denniscmcom/EVB-A32S1-M/README.md

# EVB-A32S1-M

A electronic speed controller based on a STM32 MCU. In the `Export` folder you can find an overview of the schematic, PCB and bill of materials.

## Schematic 

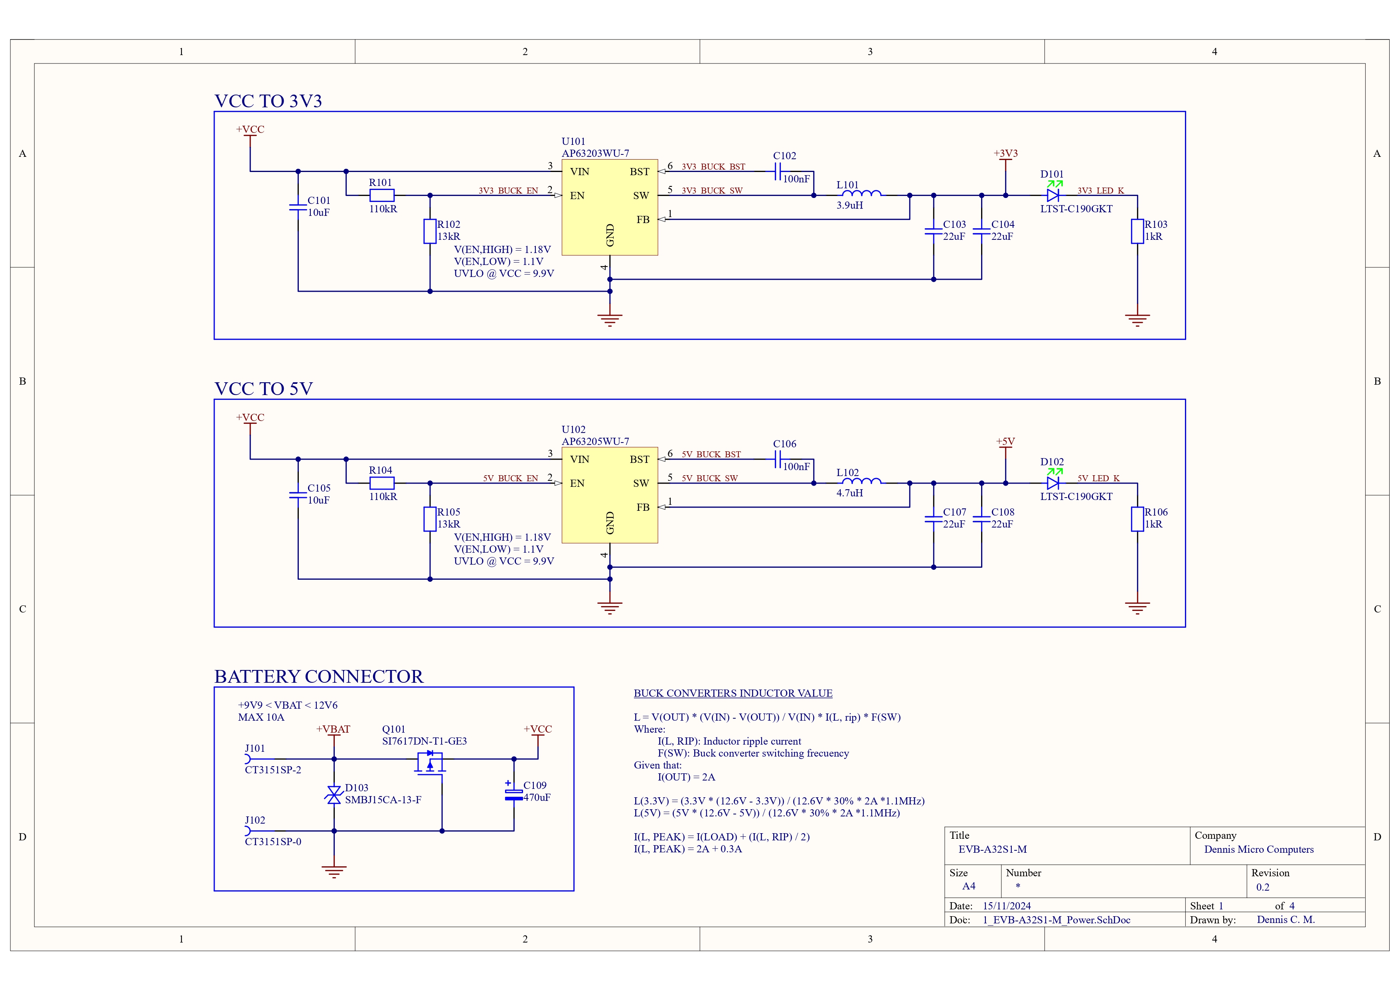
[picture p1: .github/SCH/SCH_page-0001.jpg]

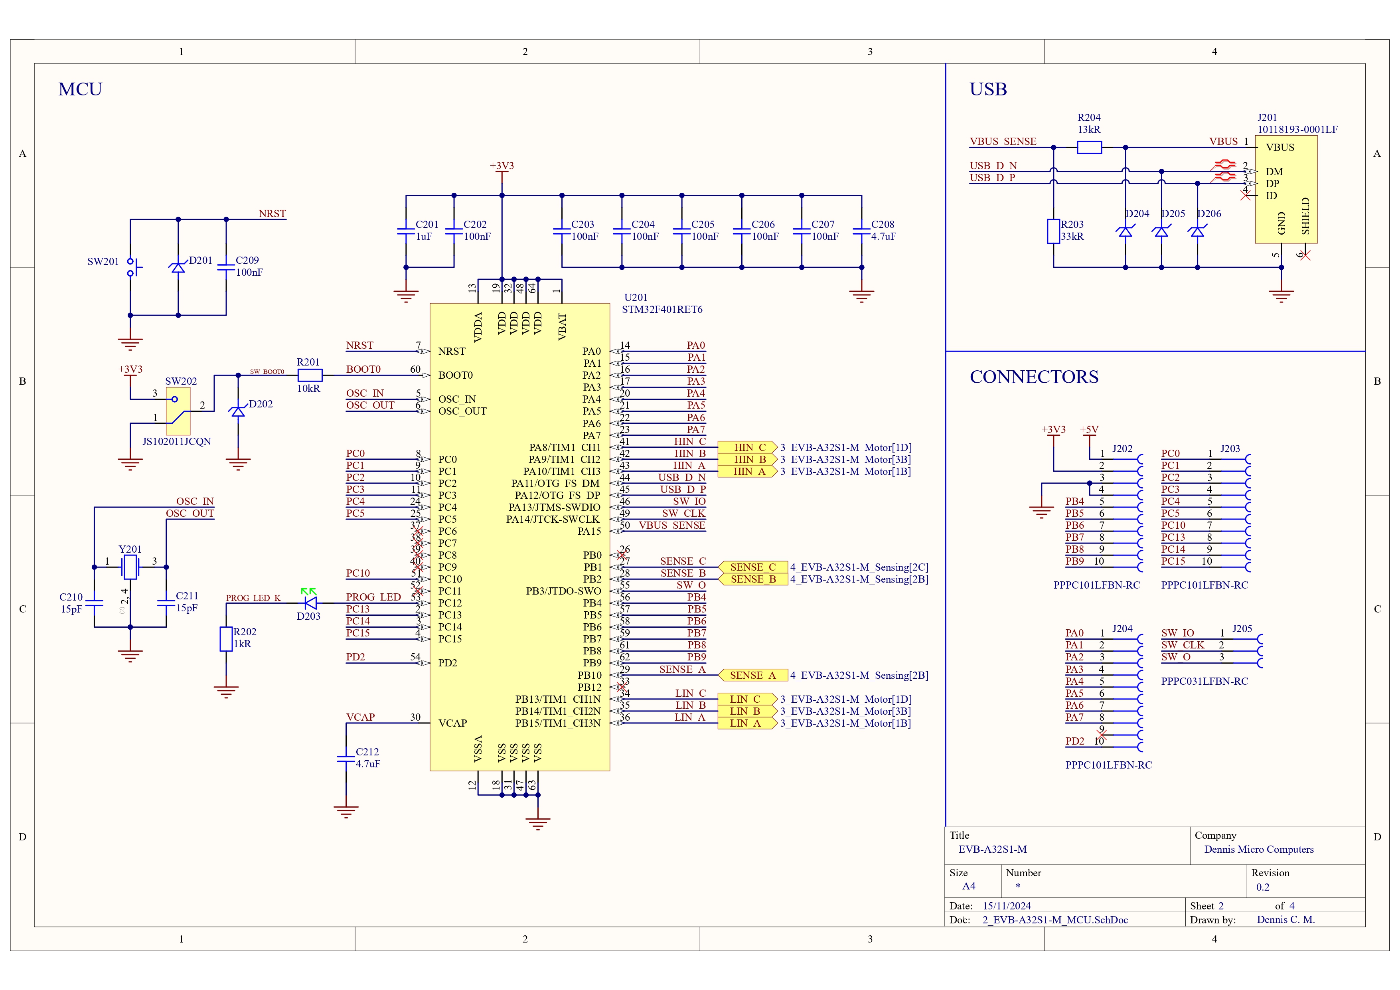
[picture p2: .github/SCH/SCH_page-0002.jpg]

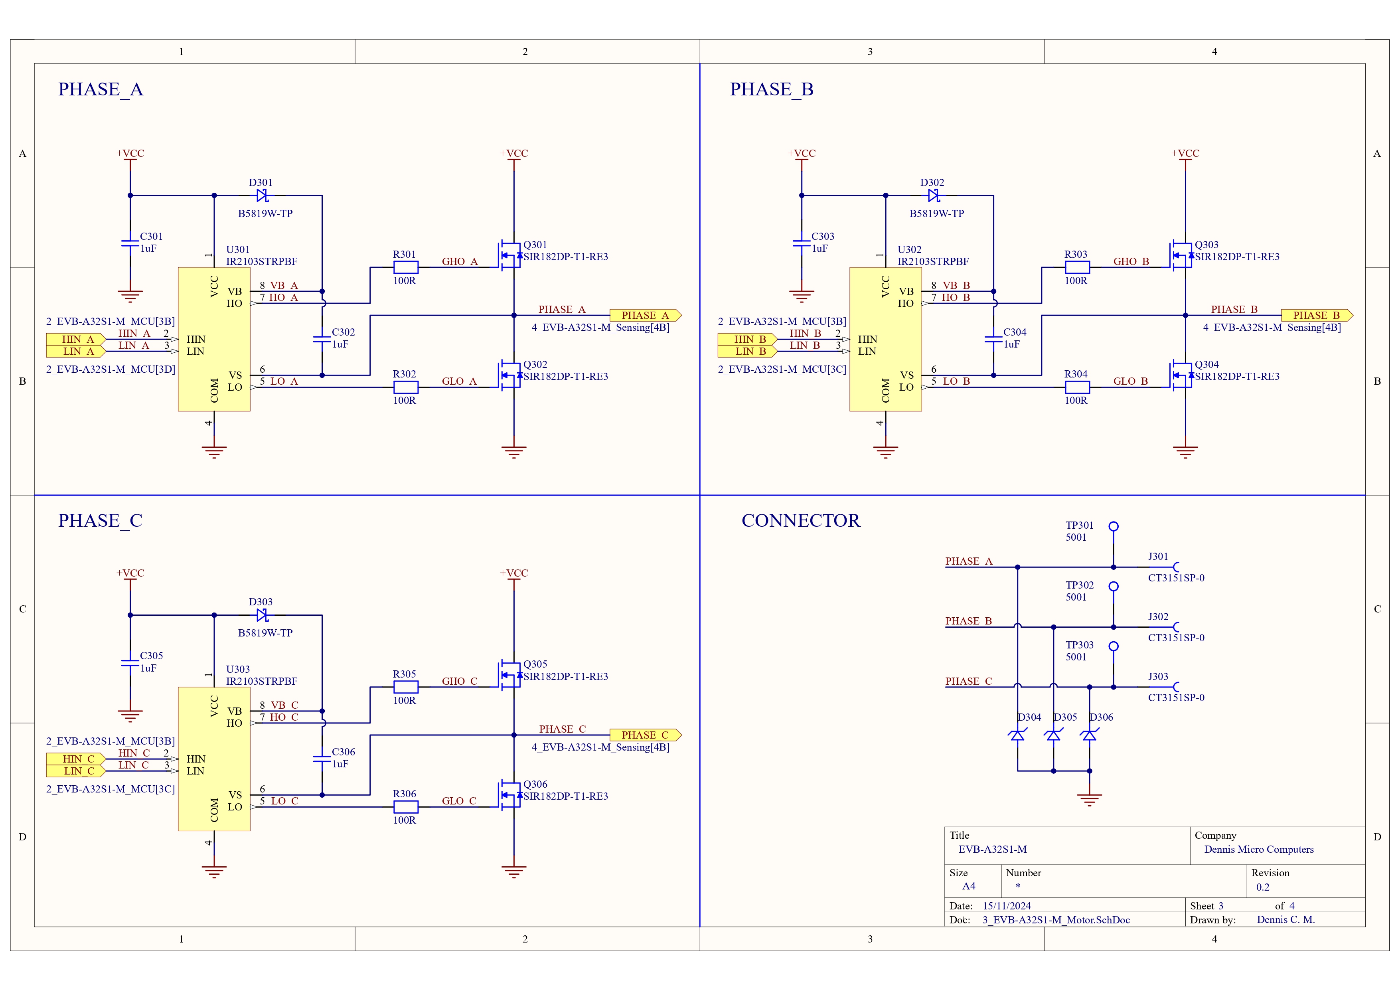
[picture p3: .github/SCH/SCH_page-0003.jpg]

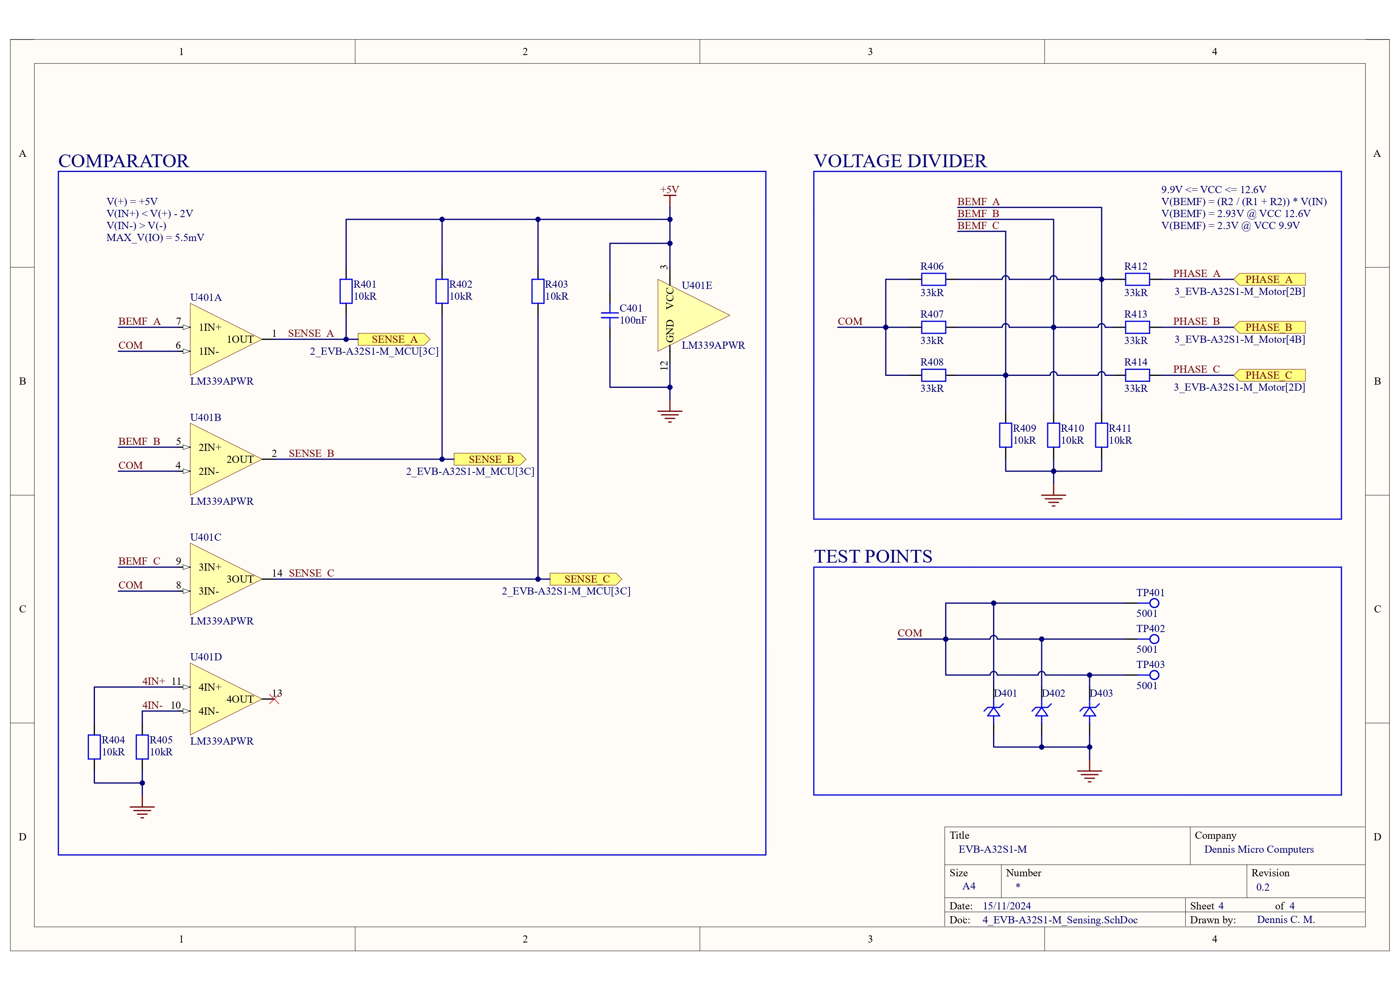
[picture p4: .github/SCH/SCH_page-0004.jpg]


## PCB

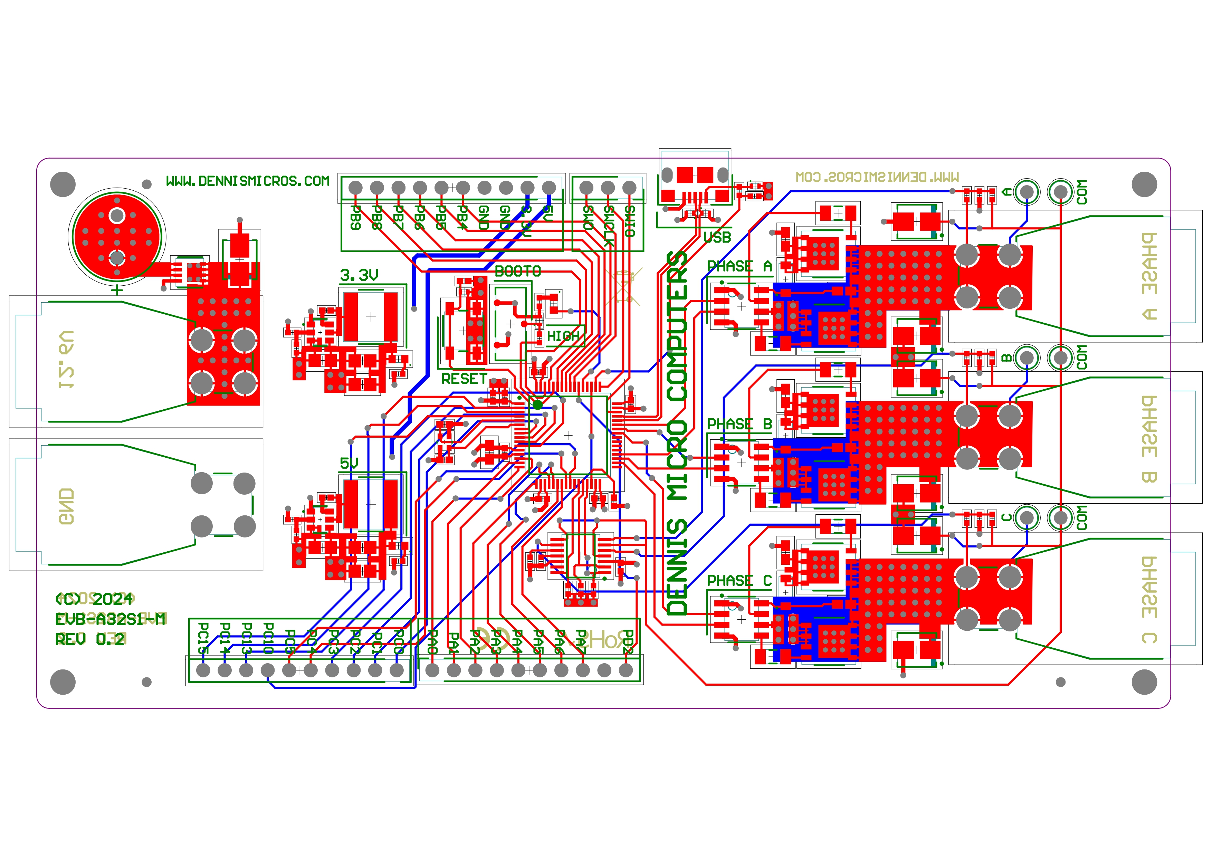
[picture p5: .github/PCB/PCB_page-0001.jpg]


## BOM

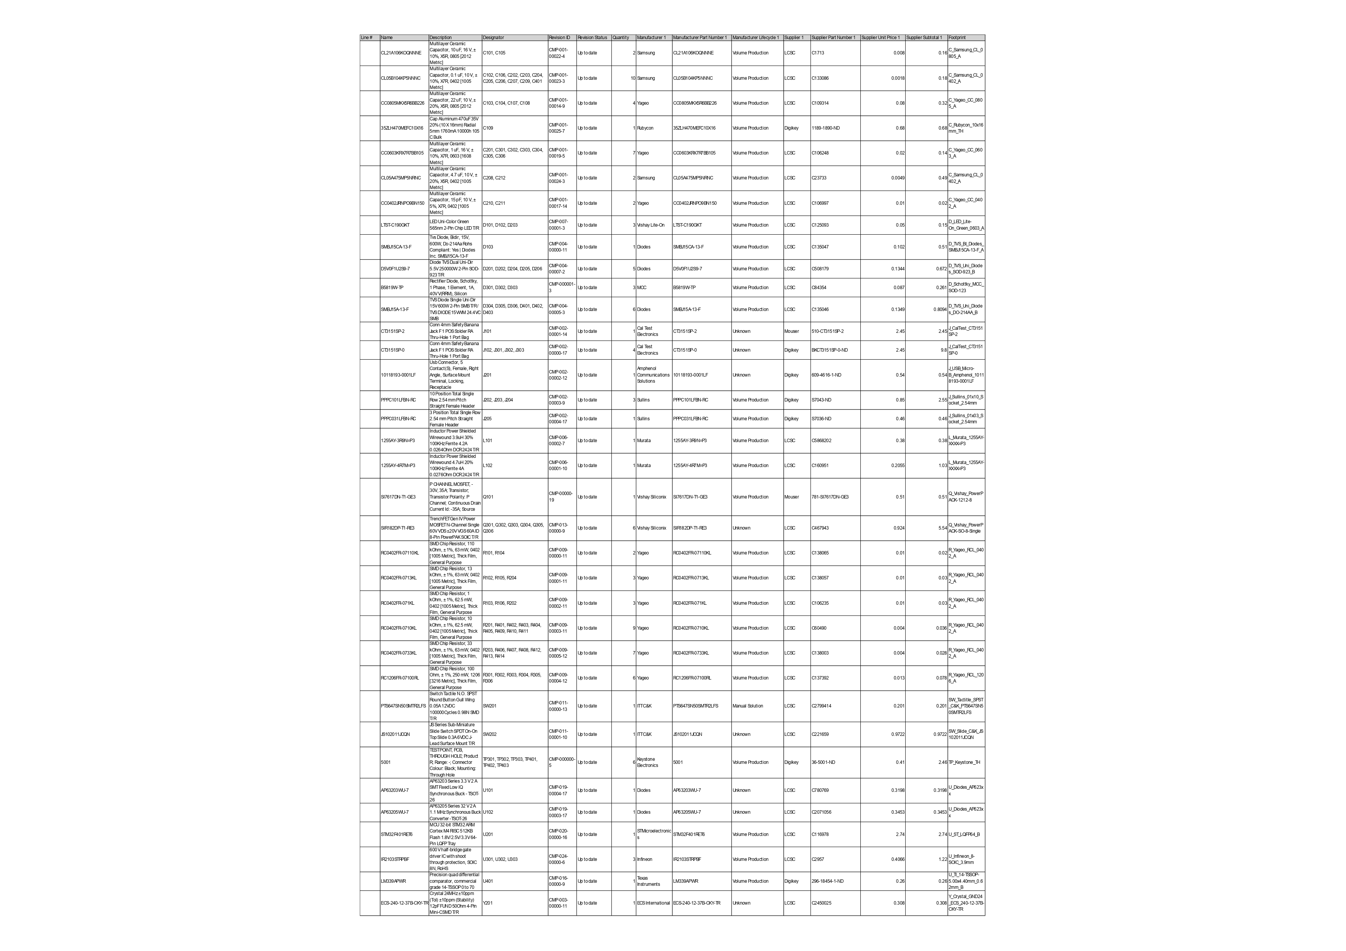
[picture p6: .github/BOM/BOM_page-0001.jpg]
