denniscmcom/EVB-A32S1-M/Export/BOM.pdf

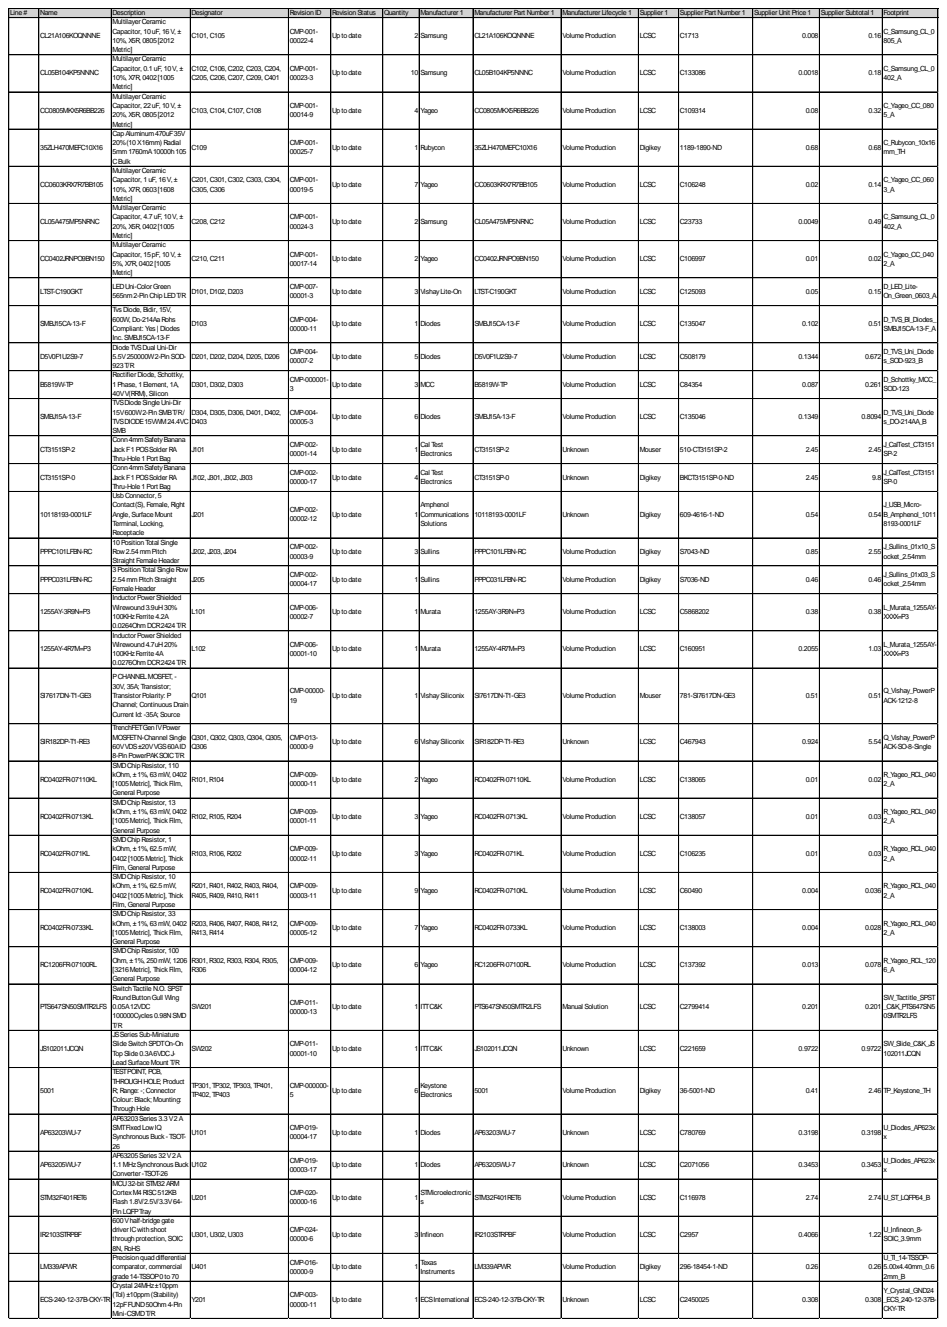
[picture p7: page 1]

Line# | Name | Description | Designator | RevisionID | RevisionStatus | Quantity | Manufacturer 1 | Manufacturer Part Number 1 | Manufacturer Lifecycle 1 | Supplier 1 | Supplier Part Number 1 | Supplier Unit Price1 | Supplier Subtotal 1 | Footprint

CL21A106KOQNNNE | Multilayer Ceramic Capacitor, 10uF, 16V, ± 10%, X5R, 0805[2012 Metric] | C101, C105 | CMP-001-00022-4 | Uptodate | 2 | Samsung | CL21A106KOQNNNE | VolumeProduction | LCSC | C1713 | 0.008 | 0.16 | C_Samsung_CL_0 805_A

CL05B104KP5NNNC | Multilayer Ceramic Capacitor, 0.1 uF, 10V, ± 10%, X7R, 0402[1005 Metric] | C102, C106, C202, C203, C204, C205, C206, C207, C209, C401 | CMP-001-00023-3 | Uptodate | 10 | Samsung | CL05B104KP5NNNC | VolumeProduction | LCSC | C133086 | 0.0018 | 0.18 | C_Samsung_CL_0 402_A

CC0805MKX5R6BB226 | Multilayer Ceramic Capacitor, 22uF, 10V, ± 20%, X5R, 0805[2012 Metric] | C103, C104, C107, C108 | CMP-001-00014-9 | Uptodate | 4 | Yageo | CC0805MKX5R6BB226 | VolumeProduction | LCSC | C109314 | 0.08 | 0.32 | C_Yageo_CC_080 5_A

35ZLH470MEFC10X16 | CapAluminum470uF35V 20%(10X16mm) Radial 5mm1760mA10000h105 CBulk | C109 | CMP-001-00025-7 | Uptodate | 1 | Rubycon | 35ZLH470MEFC10X16 | VolumeProduction | Digikey | 1189-1890-ND | 0.68 | 0.68 | C_Rubycon_10x16 mm_TH

CC0603KRX7R7BB105 | Multilayer Ceramic Capacitor, 1uF, 16V, ± 10%, X7R, 0603[1608 Metric] | C201, C301, C302, C303, C304, C305, C306 | CMP-001-00019-5 | Uptodate | 7 | Yageo | CC0603KRX7R7BB105 | VolumeProduction | LCSC | C106248 | 0.02 | 0.14 | C_Yageo_CC_060 3_A

CL05A475MP5NRNC | Multilayer Ceramic Capacitor, 4.7 uF, 10V, ± 20%, X5R, 0402[1005 Metric] | C208, C212 | CMP-001-00024-3 | Uptodate | 2 | Samsung | CL05A475MP5NRNC | VolumeProduction | LCSC | C23733 | 0.0049 | 0.49 | C_Samsung_CL_0 402_A

CC0402JRNPO9BN150 | Multilayer Ceramic Capacitor, 15pF, 10V, ± 5%, X7R, 0402[1005 Metric] | C210, C211 | CMP-001-00017-14 | Uptodate | 2 | Yageo | CC0402JRNPO9BN150 | VolumeProduction | LCSC | C106997 | 0.01 | 0.02 | C_Yageo_CC_040 2_A

LTST-C190GKT | LEDUni-Color Green 565nm2-Pin Chip LEDT/R | D101, D102, D203 | CMP-007-00001-3 | Uptodate | 3 | VishayLite-On | LTST-C190GKT | VolumeProduction | LCSC | C125093 | 0.05 | 0.15 | D_LED_Lite-On_Green_0603_A

SMBJ15CA-13-F | Tvs Diode, Bidir, 15V, 600W, Do-214AaRohs Compliant: Yes | Diodes Inc. SMBJ15CA-13-F | D103 | CMP-004-00000-11 | Uptodate | 1 | Diodes | SMBJ15CA-13-F | VolumeProduction | LCSC | C135047 | 0.102 | 0.51 | D_TVS_BI_Diodes_ SMBJ15CA-13-F_A

D5V0F1U2S9-7 | DiodeTVSDual Uni-Dir 5.5V250000W2-Pin SOD-923T/R | D201, D202, D204, D205, D206 | CMP-004-00007-2 | Uptodate | 5 | Diodes | D5V0F1U2S9-7 | VolumeProduction | LCSC | C508179 | 0.1344 | 0.672 | D_TVS_Uni_Diode s_SOD-923_B

B5819W-TP | Rectifier Diode, Schottky, 1Phase, 1Element, 1A, 40VV(RRM), Silicon | D301, D302, D303 | CMP-000001-3 | Uptodate | 3 | MCC | B5819W-TP | VolumeProduction | LCSC | C84354 | 0.087 | 0.261 | D_Schottky_MCC_ SOD-123

SMBJ15A-13-F | TVSDiodeSingle Uni-Dir 15V600W2-Pin SMBT/R/ TVSDIODE15VWM24.4VC SMB | D304, D305, D306, D401, D402, D403 | CMP-004-00005-3 | Uptodate | 6 | Diodes | SMBJ15A-13-F | VolumeProduction | LCSC | C135046 | 0.1349 | 0.8094 | D_TVS_Uni_Diode s_DO-214AA_B

CT3151SP-2 | Conn4mmSafetyBanana Jack F1POSSolder RA Thru-Hole 1Port Bag | J101 | CMP-002-00001-14 | Uptodate | 1 | Cal Test Electronics | CT3151SP-2 | Unknown | Mouser | 510-CT3151SP-2 | 2.45 | 2.45 | J_CalTest_CT3151 SP-2

CT3151SP-0 | Conn4mmSafetyBanana Jack F1POSSolder RA Thru-Hole 1Port Bag | J102, J301, J302, J303 | CMP-002-00000-17 | Uptodate | 4 | Cal Test Electronics | CT3151SP-0 | Unknown | Digikey | BKCT3151SP-0-ND | 2.45 | 9.8 | J_CalTest_CT3151 SP-0

10118193-0001LF | UsbConnector, 5 Contact(S), Female, Right Angle, SurfaceMount Terminal, Locking, Receptacle | J201 | CMP-002-00002-12 | Uptodate | 1 | Amphenol Communications Solutions | 10118193-0001LF | Unknown | Digikey | 609-4616-1-ND | 0.54 | 0.54 | J_USB_Micro-B_Amphenol_1011 8193-0001LF

PPPC101LFBN-RC | 10PositionTotal Single Row2.54mmPitch Straight Female Header | J202, J203, J204 | CMP-002-00003-9 | Uptodate | 3 | Sullins | PPPC101LFBN-RC | VolumeProduction | Digikey | S7043-ND | 0.85 | 2.55 | J_Sullins_01x10_S ocket_2.54mm

PPPC031LFBN-RC | 3PositionTotal Single Row 2.54mmPitchStraight Female Header | J205 | CMP-002-00004-17 | Uptodate | 1 | Sullins | PPPC031LFBN-RC | VolumeProduction | Digikey | S7036-ND | 0.46 | 0.46 | J_Sullins_01x03_S ocket_2.54mm

1255AY-3R9N=P3 | Inductor Power Shielded Wirewound3.9uH30% 100KHzFerrite4.2A 0.0264OhmDCR2424T/R | L101 | CMP-006-00002-7 | Uptodate | 1 | Murata | 1255AY-3R9N=P3 | VolumeProduction | LCSC | C5868202 | 0.38 | 0.38 | L_Murata_1255AY-XXXX=P3

1255AY-4R7M=P3 | Inductor Power Shielded Wirewound4.7uH20% 100KHzFerrite4A 0.0276OhmDCR2424T/R | L102 | CMP-006-00001-10 | Uptodate | 1 | Murata | 1255AY-4R7M=P3 | VolumeProduction | LCSC | C160951 | 0.2055 | 1.03 | L_Murata_1255AY-XXXX=P3

SI7617DN-T1-GE3 | PCHANNELMOSFET, -30V, 35A; Transistor; Transistor Polarity: P Channel; Continuous Drain Current Id: -35A; Source | Q101 | CMP-00000-19 | Uptodate | 1 | VishaySiliconix | SI7617DN-T1-GE3 | VolumeProduction | Mouser | 781-SI7617DN-GE3 | 0.51 | 0.51 | Q_Vishay_PowerP ACK-1212-8

SIR182DP-T1-RE3 | TrenchFETGenIVPower MOSFETN-Channel Single 60VVDS±20VVGS60AID 8-Pin PowerPAKSOICT/R | Q301, Q302, Q303, Q304, Q305, Q306 | CMP-013-00000-9 | Uptodate | 6 | VishaySiliconix | SIR182DP-T1-RE3 | Unknown | LCSC | C467943 | 0.924 | 5.54 | Q_Vishay_PowerP ACK-SO-8-Single

RC0402FR-07110KL | SMDChip Resistor, 110 kOhm, ± 1%, 63mW, 0402 [1005Metric], Thick Film, General Purpose | R101, R104 | CMP-009-00000-11 | Uptodate | 2 | Yageo | RC0402FR-07110KL | VolumeProduction | LCSC | C138065 | 0.01 | 0.02 | R_Yageo_RCL_040 2_A

RC0402FR-0713KL | SMDChip Resistor, 13 kOhm, ± 1%, 63mW, 0402 [1005Metric], Thick Film, General Purpose | R102, R105, R204 | CMP-009-00001-11 | Uptodate | 3 | Yageo | RC0402FR-0713KL | VolumeProduction | LCSC | C138057 | 0.01 | 0.03 | R_Yageo_RCL_040 2_A

RC0402FR-071KL | SMDChip Resistor, 1 kOhm, ± 1%, 62.5 mW, 0402[1005Metric], Thick Film, General Purpose | R103, R106, R202 | CMP-009-00002-11 | Uptodate | 3 | Yageo | RC0402FR-071KL | VolumeProduction | LCSC | C106235 | 0.01 | 0.03 | R_Yageo_RCL_040 2_A

RC0402FR-0710KL | SMDChip Resistor, 10 kOhm, ± 1%, 62.5 mW, 0402[1005Metric], Thick Film, General Purpose | R201, R401, R402, R403, R404, R405, R409, R410, R411 | CMP-009-00003-11 | Uptodate | 9 | Yageo | RC0402FR-0710KL | VolumeProduction | LCSC | C60490 | 0.004 | 0.036 | R_Yageo_RCL_040 2_A

RC0402FR-0733KL | SMDChip Resistor, 33 kOhm, ± 1%, 63mW, 0402 [1005Metric], Thick Film, General Purpose | R203, R406, R407, R408, R412, R413, R414 | CMP-009-00005-12 | Uptodate | 7 | Yageo | RC0402FR-0733KL | VolumeProduction | LCSC | C138003 | 0.004 | 0.028 | R_Yageo_RCL_040 2_A

RC1206FR-07100RL | SMDChip Resistor, 100 Ohm, ± 1%, 250mW, 1206 [3216Metric], Thick Film, General Purpose | R301, R302, R303, R304, R305, R306 | CMP-009-00004-12 | Uptodate | 6 | Yageo | RC1206FR-07100RL | VolumeProduction | LCSC | C137392 | 0.013 | 0.078 | R_Yageo_RCL_120 6_A

PTS647SN50SMTR2LFS | SwitchTactile N.O. SPST RoundButtonGull Wing 0.05A12VDC 100000Cycles 0.98NSMD T/R | SW201 | CMP-011-00000-13 | Uptodate | 1 | ITTC&K | PTS647SN50SMTR2LFS | Manual Solution | LCSC | C2799414 | 0.201 | 0.201 | SW_Tactitle_SPST _C&K_PTS647SN5 0SMTR2LFS

JS102011JCQN | JSSeriesSub-Miniature SlideSwitchSPDTOn-On TopSlide0.3A6VDCJ-LeadSurfaceMount T/R | SW202 | CMP-011-00001-10 | Uptodate | 1 | ITTC&K | JS102011JCQN | Unknown | LCSC | C221659 | 0.9722 | 0.9722 | SW_Slide_C&K_JS 102011JCQN

5001 | TESTPOINT, PCB, THROUGHHOLE; Product R; Range: -; Connector Colour: Black; Mounting: ThroughHole | TP301, TP302, TP303, TP401, TP402, TP403 | CMP-000000-5 | Uptodate | 6 | Keystone Electronics | 5001 | VolumeProduction | Digikey | 36-5001-ND | 0.41 | 2.46 | TP_Keystone_TH

AP63203WU-7 | AP63203Series 3.3V2A SMTFixedLowIQ SynchronousBuck - TSOT-26 | U101 | CMP-019-00004-17 | Uptodate | 1 | Diodes | AP63203WU-7 | Unknown | LCSC | C780769 | 0.3198 | 0.3198 | U_Diodes_AP623x x

AP63205WU-7 | AP63205Series 32V2A 1.1 MHzSynchronousBuck Converter -TSOT-26 | U102 | CMP-019-00003-17 | Uptodate | 1 | Diodes | AP63205WU-7 | Unknown | LCSC | C2071056 | 0.3453 | 0.3453 | U_Diodes_AP623x x

STM32F401RET6 | MCU32-bit STM32ARM CortexM4RISC512KB Flash1.8V/2.5V/3.3V64-Pin LQFPTray | U201 | CMP-020-00000-16 | Uptodate | 1 | STMicroelectronic s | STM32F401RET6 | VolumeProduction | LCSC | C116978 | 2.74 | 2.74 | U_ST_LQFP64_B

IR2103STRPBF | 600Vhalf-bridgegate driver ICwithshoot throughprotection, SOIC 8N, RoHS | U301, U302, U303 | CMP-024-00000-6 | Uptodate | 3 | Infineon | IR2103STRPBF | VolumeProduction | LCSC | C2957 | 0.4066 | 1.22 | U_Infineon_8-SOIC_3.9mm

LM339APWR | Precisionquaddifferential comparator, commercial grade14-TSSOP0to70 | U401 | CMP-016-00000-9 | Uptodate | 1 | Texas Instruments | LM339APWR | VolumeProduction | Digikey | 296-18454-1-ND | 0.26 | 0.26 | U_TI_14-TSSOP-5.00x4.40mm_0.6 2mm_B

ECS-240-12-37B-CKY-TR | Crystal 24MHz±10ppm (Tol) ±10ppm(Stability) 12pFFUND50Ohm4-Pin Mini-CSMDT/R | Y201 | CMP-003-00000-11 | Uptodate | 1 | ECSInternational | ECS-240-12-37B-CKY-TR | Unknown | LCSC | C2450025 | 0.308 | 0.308 | Y_Crystal_GND24 _ECS_240-12-37B-CKY-TR
