denniscmcom/EVB-A32S1-M/Export/SCH.pdf

# VCC TO 3V3

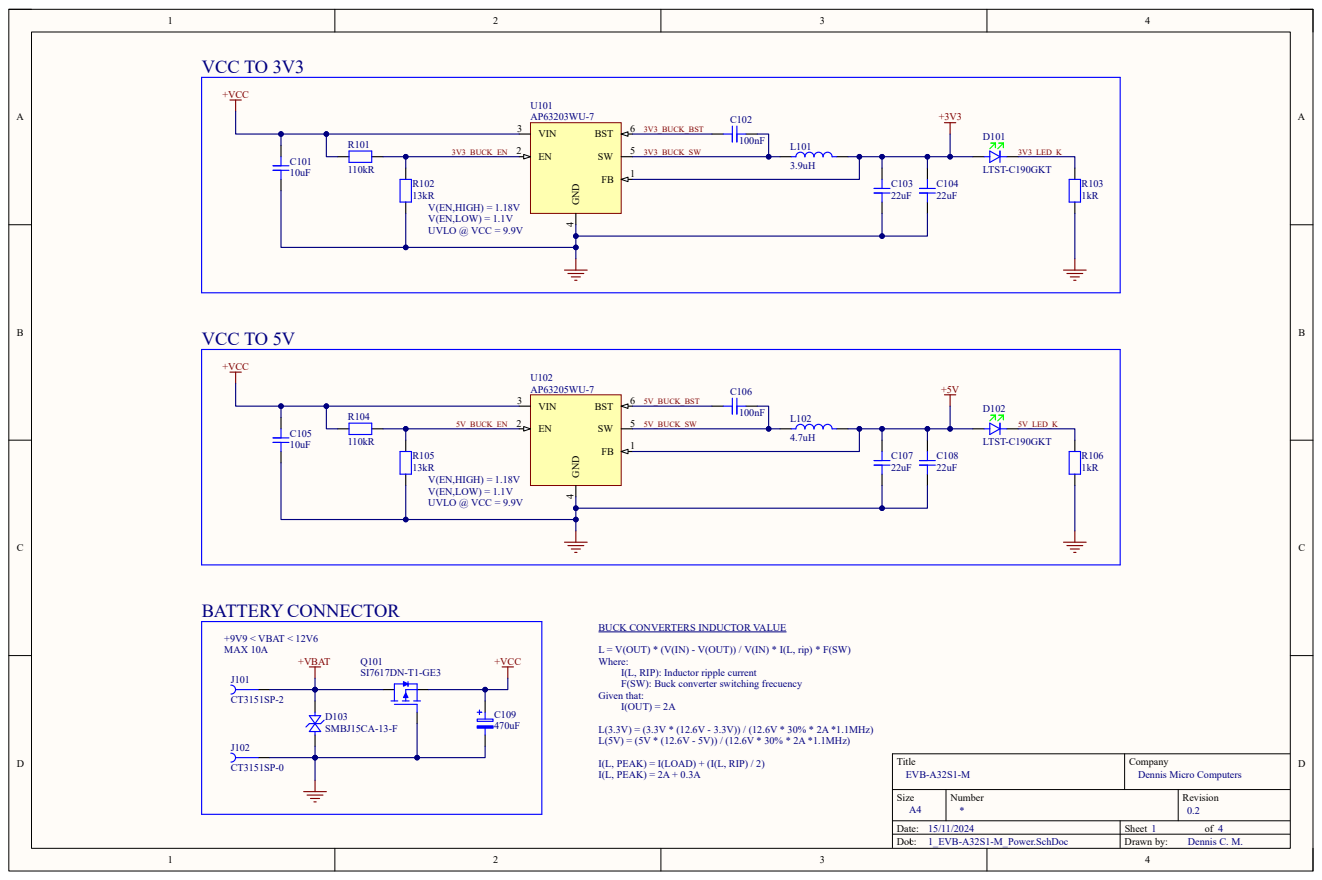
[picture p8: page 1]

BUCK CONVERTERS INDUCTOR VALUE

L = V(OUT) * (V(IN) - V(OUT)) / V(IN) * I(L, rip) * F(SW)
Where:
I(L, RIP): Inductor ripple current
F(SW): Buck converter switching frecuency
Given that:
I(OUT) = 2A

MCU | USB

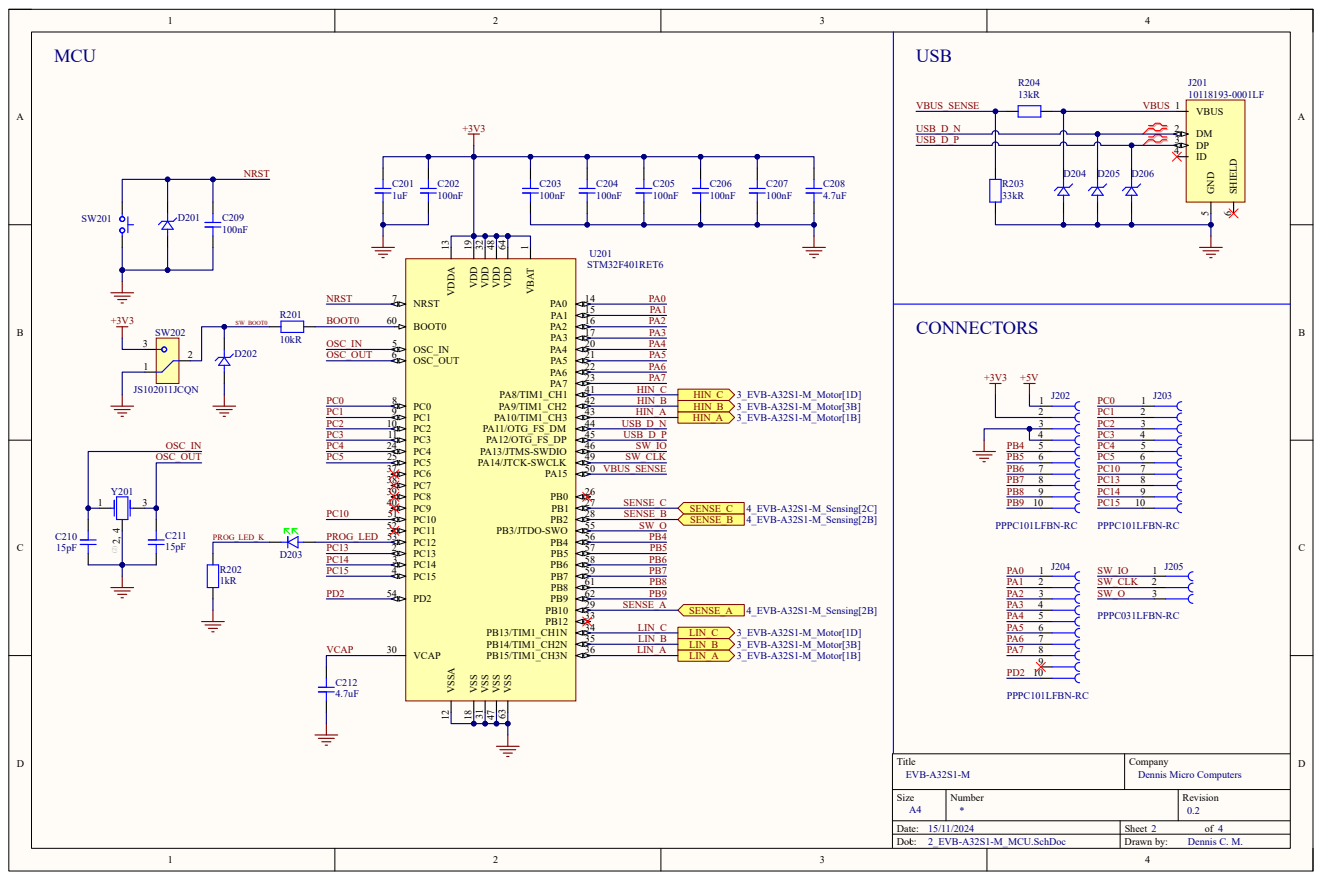
[picture p9: page 2]

PHASE_A | PHASE_B

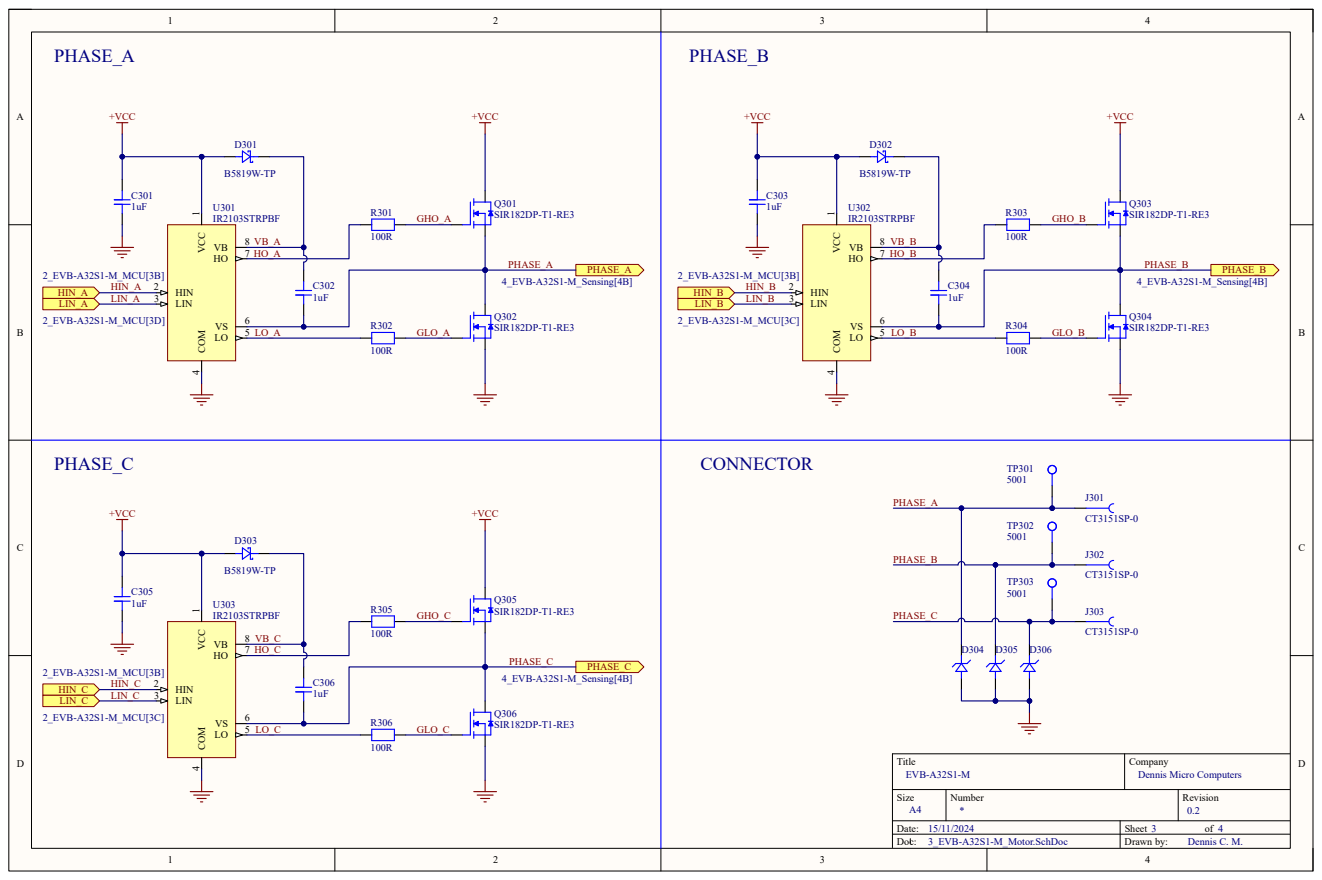
[picture p10: page 3]

COMPARATOR | VOLTAGE DIVIDER

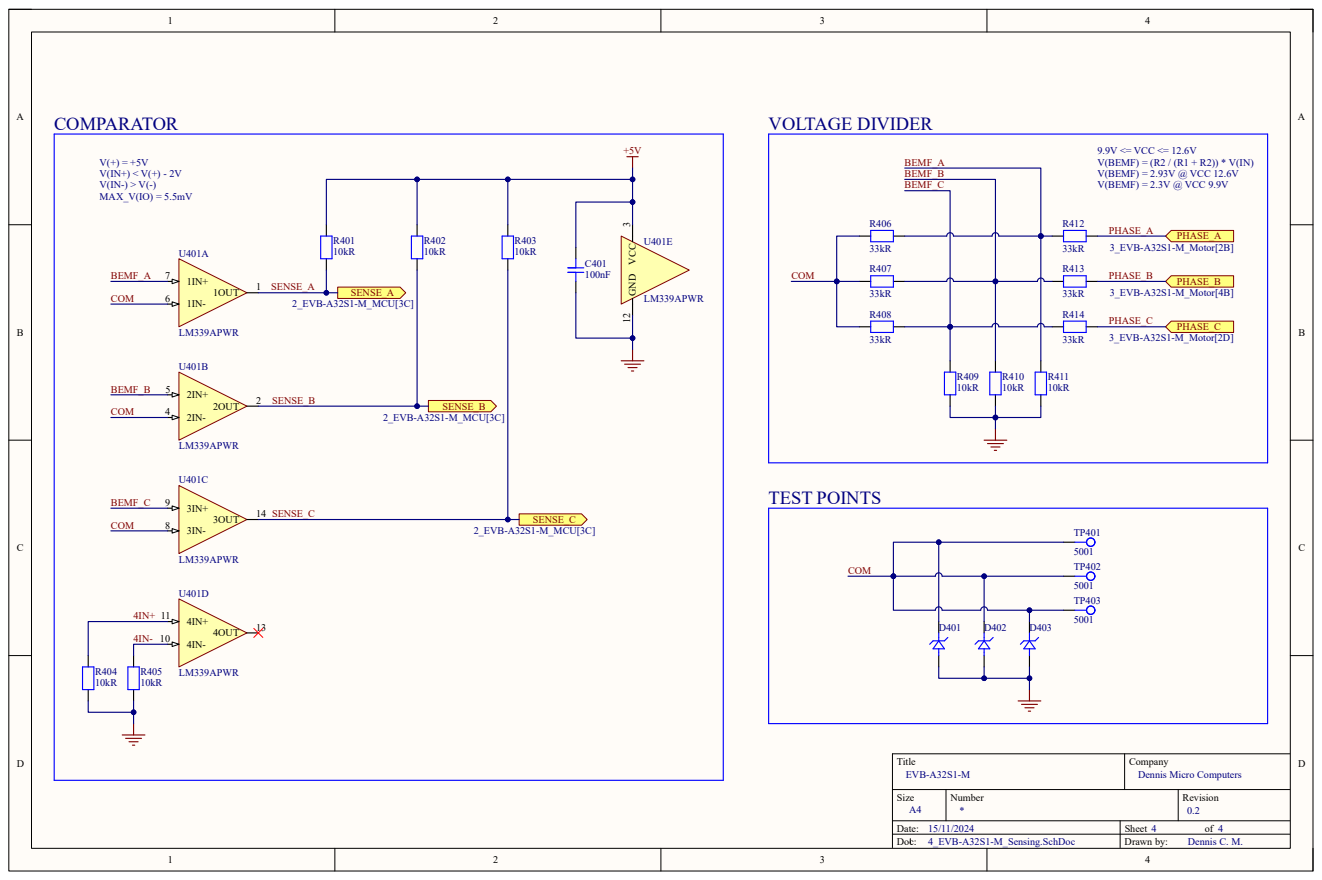
[picture p11: page 4]
