denniscmcom/EVB-A32S1-M/Export/PCB.pdf

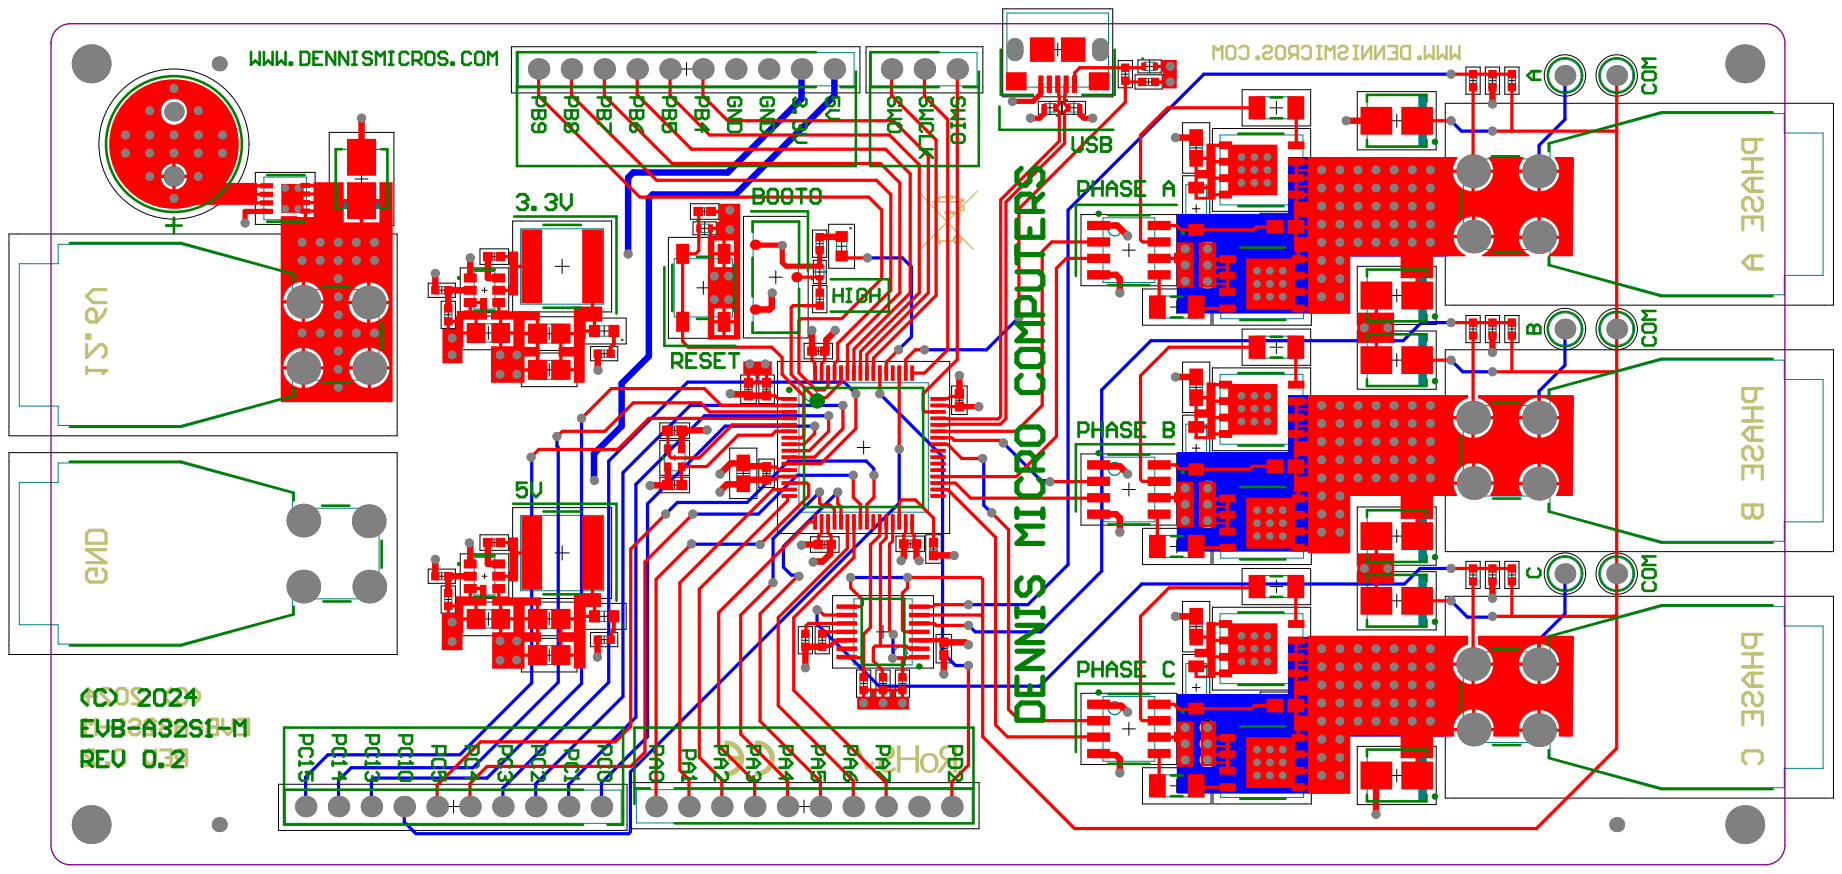
[picture p12: page 1]
