denniscmcom/EVB-A32S1-M/(list of files, drawings)

Other design files:
1_EVB-A32S1-M_Power.SchDoc
2_EVB-A32S1-M_MCU.SchDoc
3_EVB-A32S1-M_Motor.SchDoc
4_EVB-A32S1-M_Sensing.SchDoc
EVB-A32S1-M.PrjPcb
EVB-A32S1-M_PCB1.PcbDoc
EVB-A32S1-M_PCB.PcbDoc
