denniscmcom/EVB-A32S1-M/(commit log)

2024-06-08 Managed project "EVB-A32S1-M" created from AD
    [EVB-A32S1-M.PrjPcb]
2024-06-19 Finish schematic revision
    [1_Power.SchDoc, 2_MCU.SchDoc, 3_Motor.SchDoc, 4_Sensing.SchDoc]
2024-06-19 Add PCB file
    [1_EVB-A32S1-M_Power.SchDoc, 2_EVB-A32S1-M_MCU.SchDoc, 3_EVB-A32S1-M_Motor.SchDoc, 4_EVB-A32S1-M_Sensing.SchDoc, EVB-A32S1-M.PrjPcb, EVB-A32S1-M_PCB.PcbDoc]
2024-06-21 Finish layout
    [1_EVB-A32S1-M_Power.SchDoc, 2_EVB-A32S1-M_MCU.SchDoc, 4_EVB-A32S1-M_Sensing.SchDoc, EVB-A32S1-M_PCB.PcbDoc]
2024-06-24 Finish routing
    [EVB-A32S1-M_PCB.PcbDoc]
2024-06-26 Add detail silkscreen
2024-07-02 Manufacture rev 0.2 with Aisler
    [2_EVB-A32S1-M_MCU.SchDoc, EVB-A32S1-M.PrjPcb]
2024-07-09 Rename BOM
    [EVB-A32S1-M.PrjPcb]
2024-09-04 Export production files
    [EVB-A32S1-M.PrjPcb]
